mertguzelmansur/Pisa_tower_esp32_c3/s60_inside.png

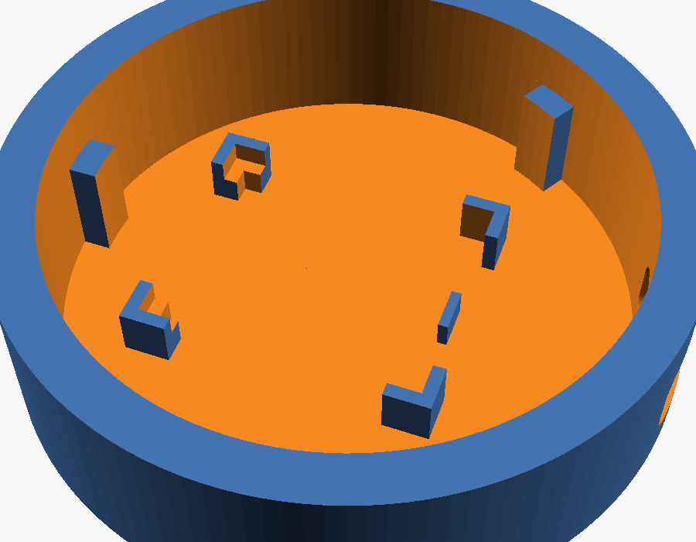
s60_inside.png
