mertguzelmansur/Pisa_tower_esp32_c3/S60_lid_1.stl

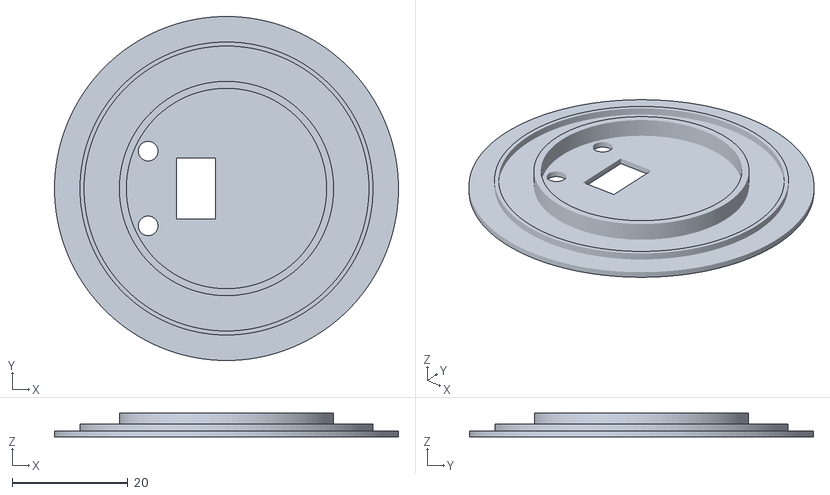
[picture p2: CAD file, 2026-10-20]
S60_lid_1.stl
59.4 x 59.4 x 4.10
