mertguzelmansur/Pisa_tower_esp32_c3/ESP32-C3-OLED4.2.step

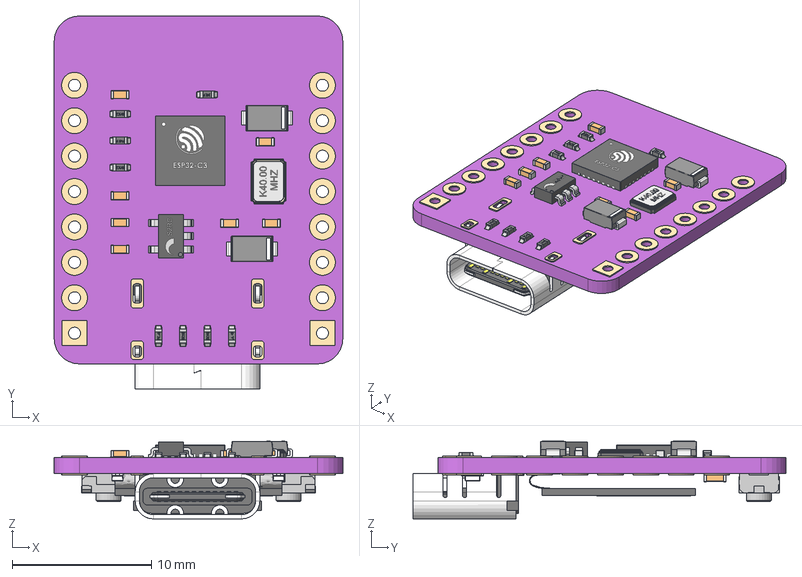
[picture p3: CAD file, 2026-10-20]
ESP32-C3-OLED4.2.step
20.7 x 26.7 x 5.58 mm
ESP32-C3
40.00 MHz Oscillator v1
Light x 2
Anode Bottom x 2
Cathode Bottom x 2
Anode x 2
Cathode x 2
Base x 2
3x4x2 tact button v1 v1 x 2
ME6211-SOT23 v1
USB_type_C_smd_12p v1
Anode Bottom (1)
Cathode Bottom (1)
Anode (1)
Cathode (1)
Base (1)
Text
Board
OLED 4.2
Pads
Resistor 0402 v1 x 8
Resistor 0402 v1 (1)
Refdes x 2
Cathode (2) x 2
Anode (2) x 2
