mertguzelmansur/Pisa_tower_esp32_c3/S60_pins_1.stl

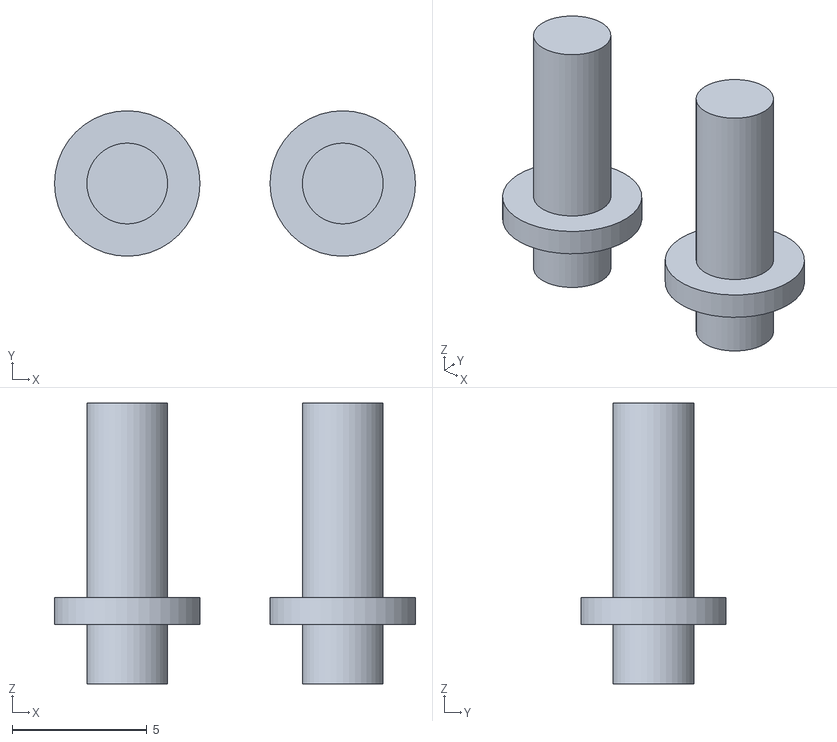
[picture p4: CAD file, 2026-10-20]
S60_pins_1.stl
13.4 x 5.40 x 10.4
