mertguzelmansur/Pisa_tower_esp32_c3/s60_assembly_1.png

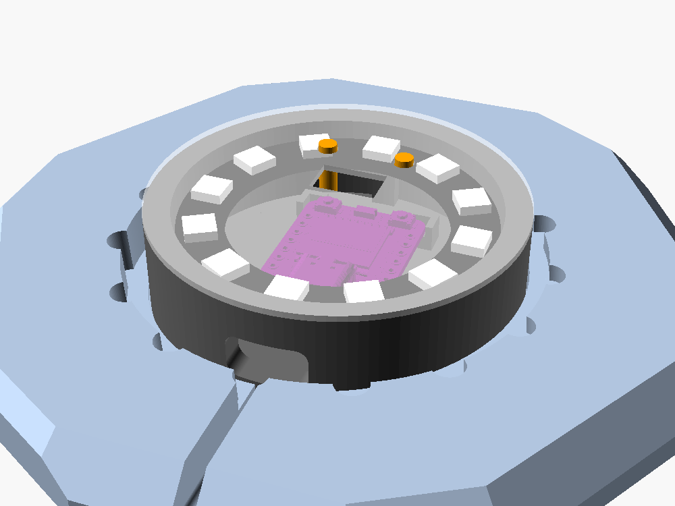
s60_assembly_1.png
